ominseo5/robotory_SoftFinger/finger_diff_diameter/DIFF18.png

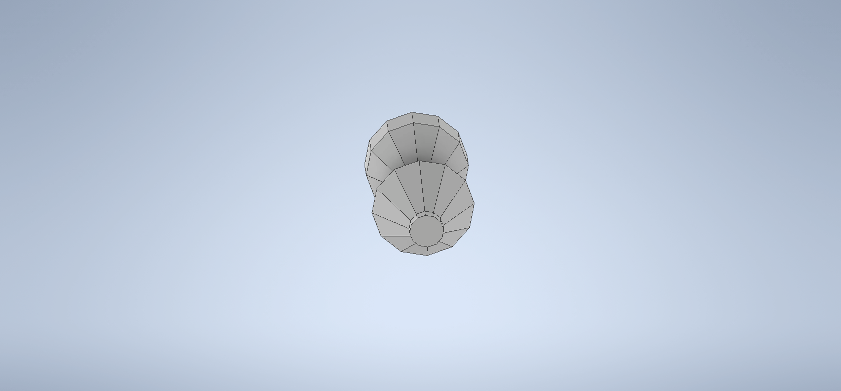
finger_diff_diameter/DIFF18.png
