ominseo5/robotory_SoftFinger/AverageDataSubplot_WithRawData/dn_series.png

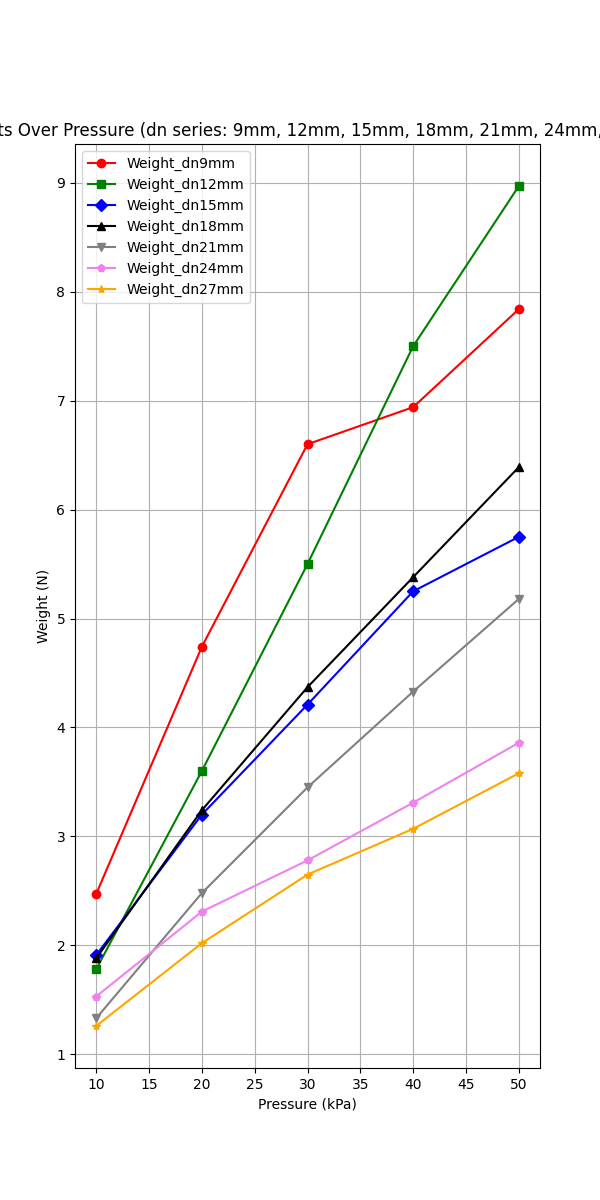
AverageDataSubplot_WithRawData/dn_series.png
