ominseo5/robotory_SoftFinger/AverageDataSubplot_WithRawData/dn_series_indiv.png

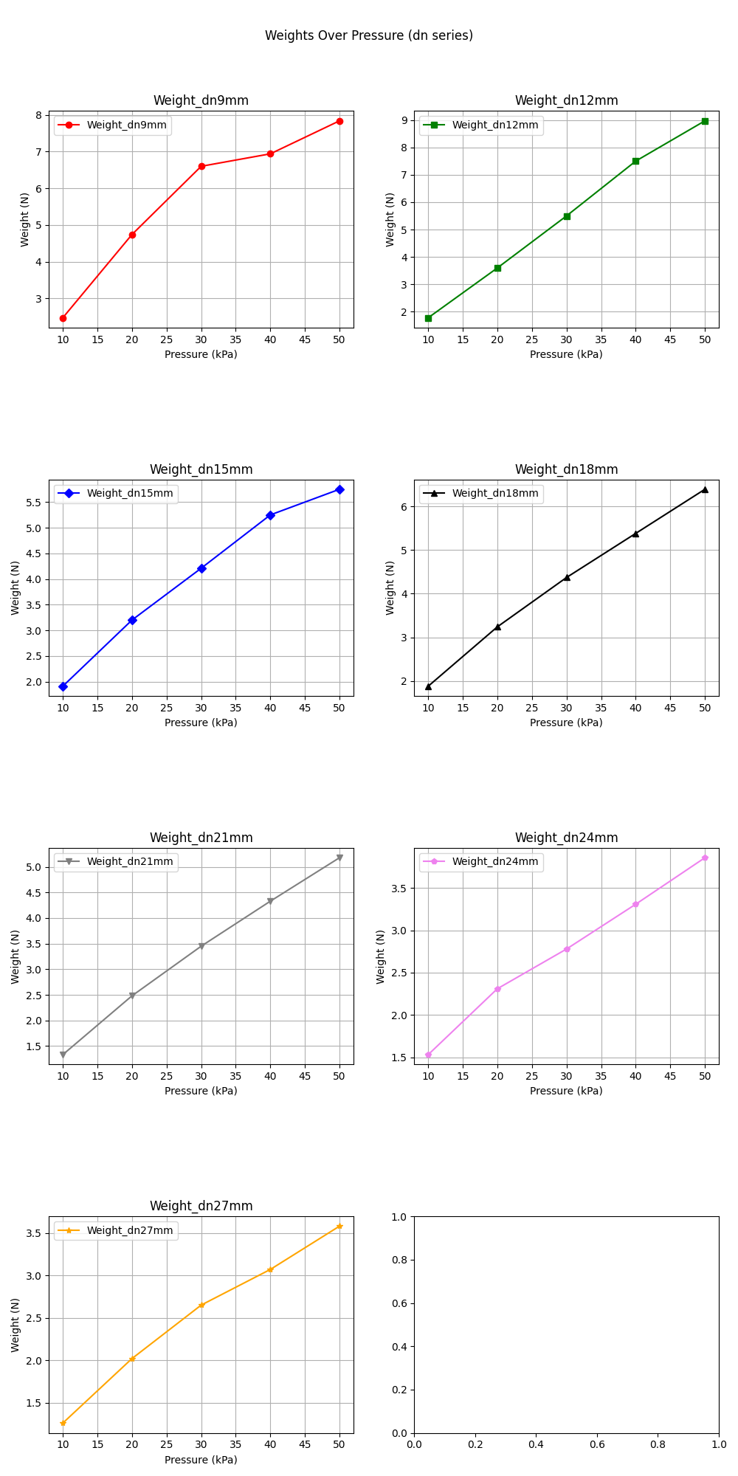
AverageDataSubplot_WithRawData/dn_series_indiv.png
