ominseo5/robotory_SoftFinger/AverageDataSubplot_WithRawData/dp_series.png

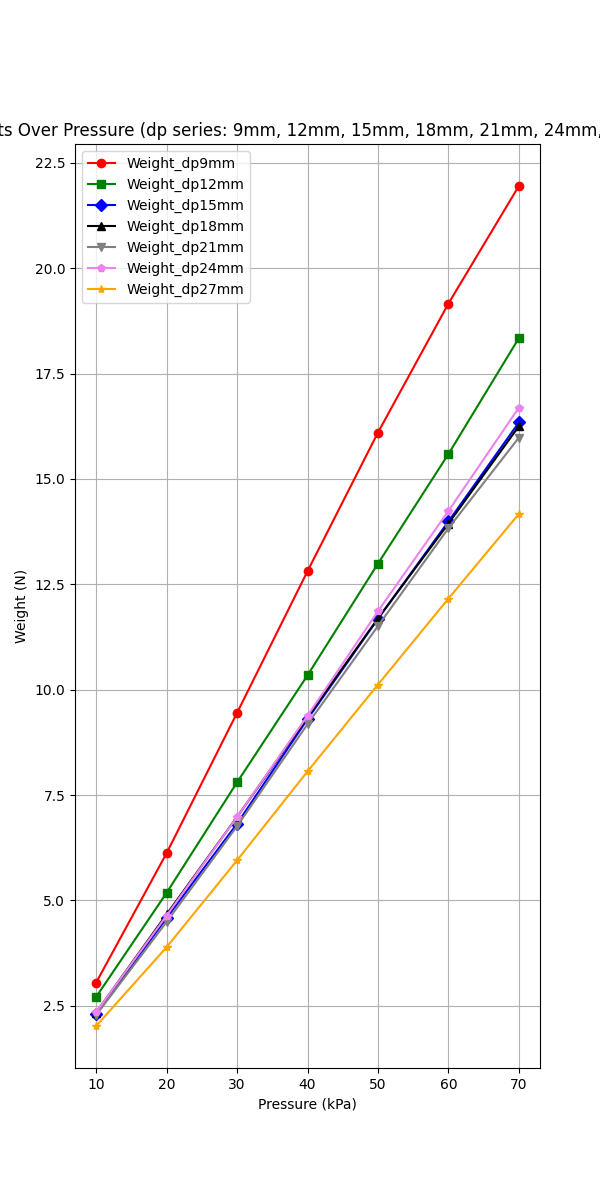
AverageDataSubplot_WithRawData/dp_series.png
