ominseo5/robotory_SoftFinger/AverageDataSubplot_WithRawData/dp_series_indiv.png

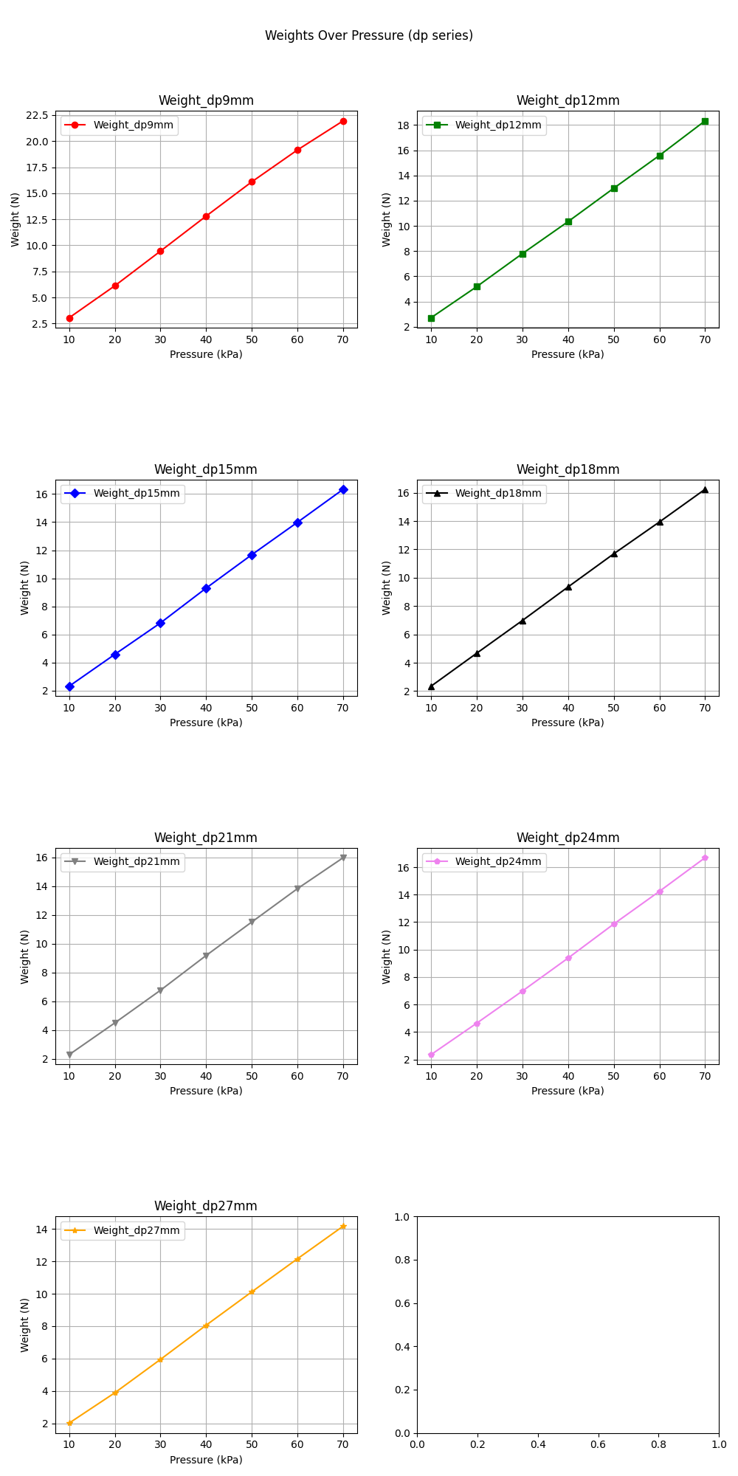
AverageDataSubplot_WithRawData/dp_series_indiv.png
