ominseo5/robotory_SoftFinger/AverageDataSubplot_WithRawData/un_series.png

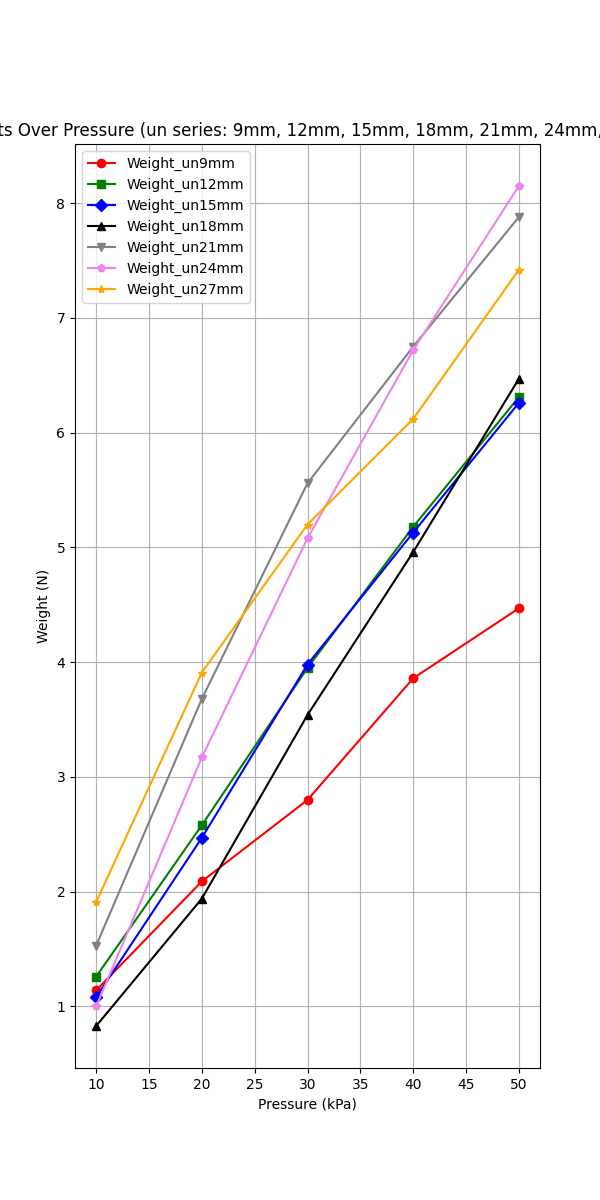
AverageDataSubplot_WithRawData/un_series.png
