ominseo5/robotory_SoftFinger/AverageDataSubplot_WithRawData/un_series_indiv.png

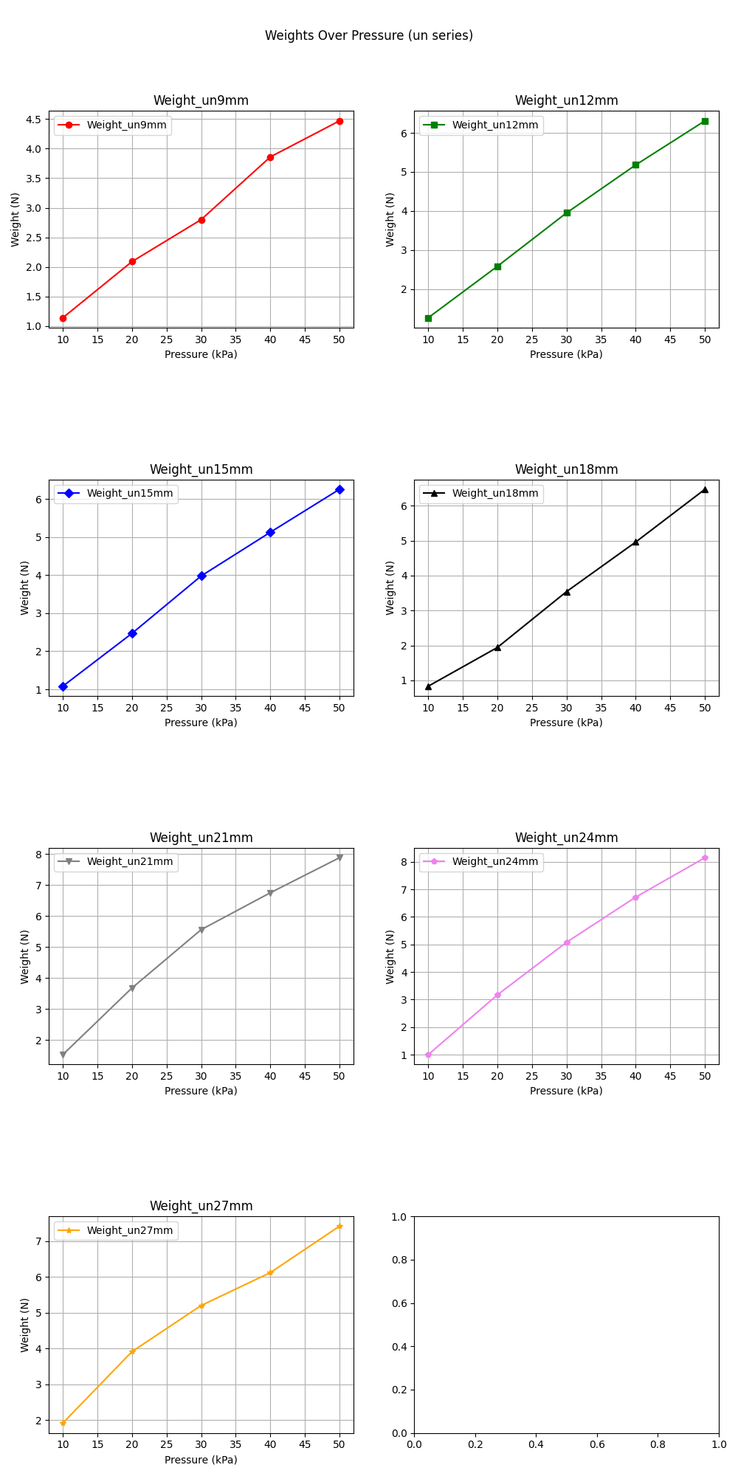
AverageDataSubplot_WithRawData/un_series_indiv.png
