ominseo5/robotory_SoftFinger/AverageDataSubplot_WithRawData/up_series.png

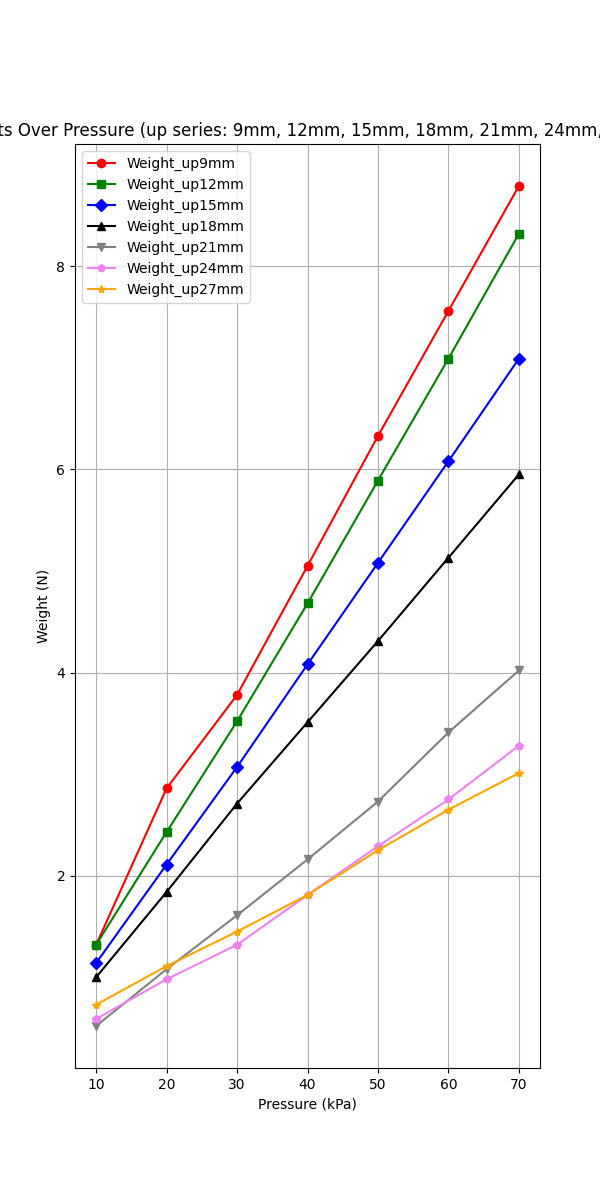
AverageDataSubplot_WithRawData/up_series.png
