ominseo5/robotory_SoftFinger/finger_PNGFiles/d18mm.png

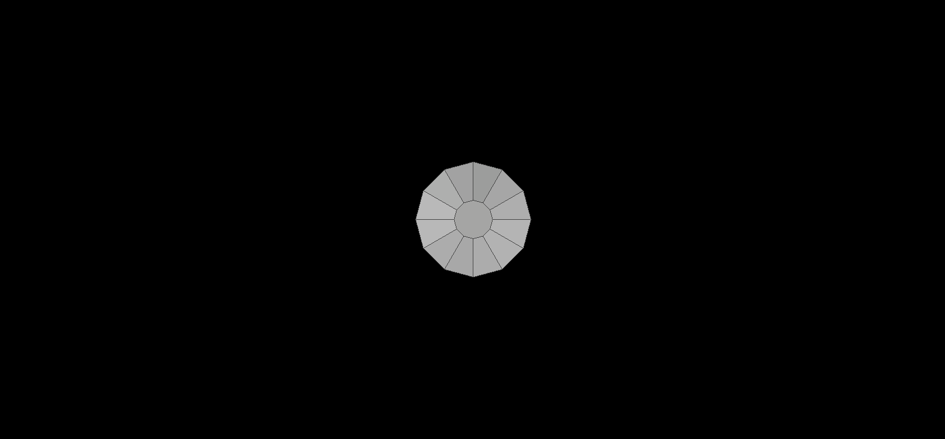
finger_PNGFiles/d18mm.png
