ominseo5/robotory_SoftFinger/finger_PNGFiles/d36mm.png

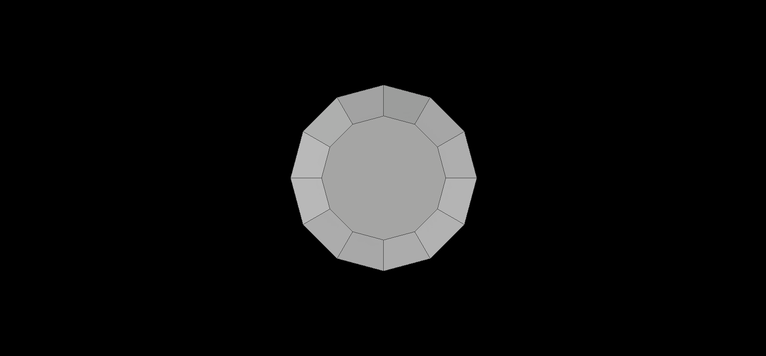
finger_PNGFiles/d36mm.png
