ominseo5/robotory_SoftFinger/finger_PNGFiles/h24mm.png

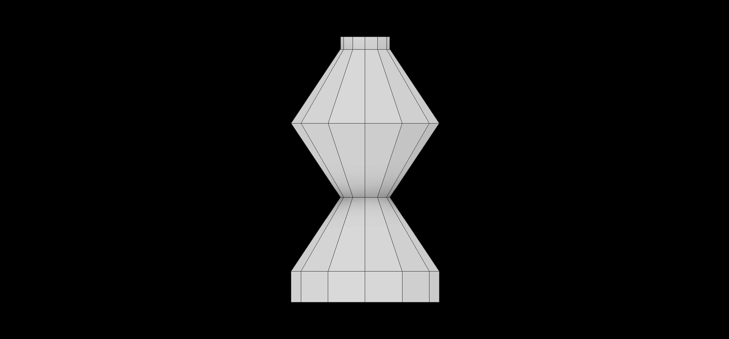
finger_PNGFiles/h24mm.png
