ominseo5/robotory_SoftFinger/PycharmCodes_xlsxFiles/ErrorBars/dn_errorbar_diffn.png

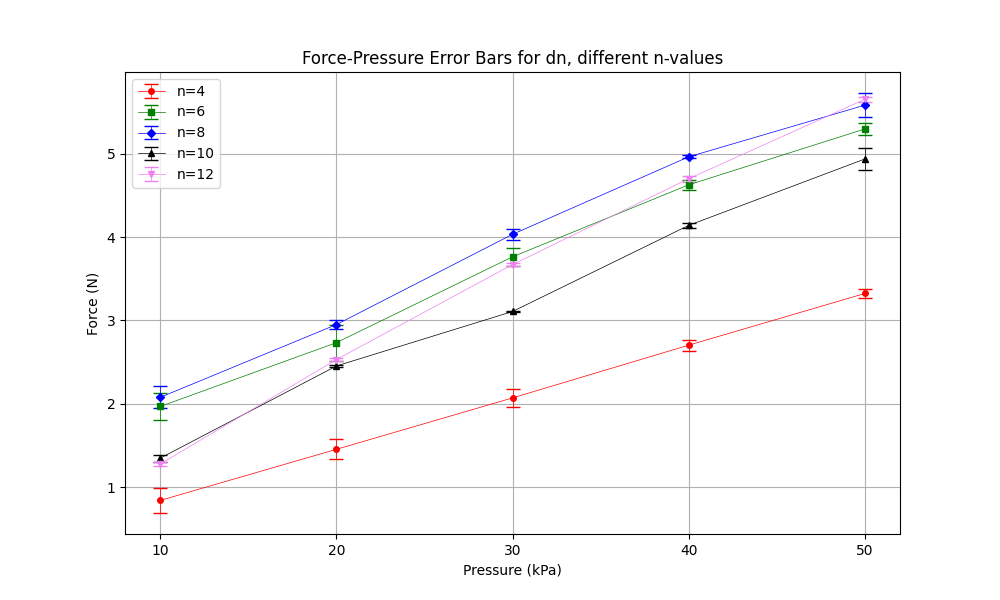
PycharmCodes_xlsxFiles/ErrorBars/dn_errorbar_diffn.png
