ominseo5/robotory_SoftFinger/PycharmCodes_xlsxFiles/ErrorBars/dp_errorbar_diffn.png

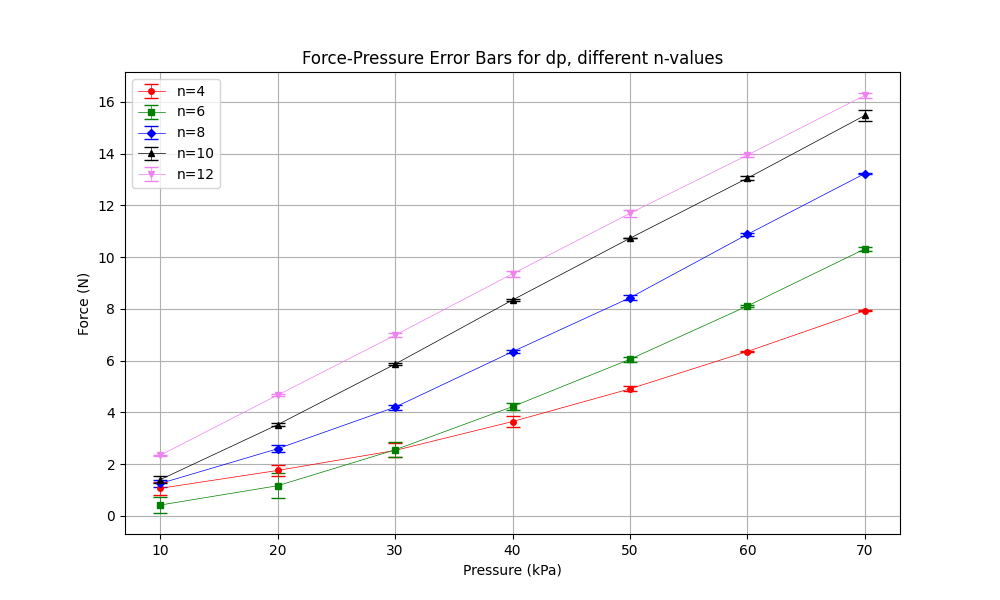
PycharmCodes_xlsxFiles/ErrorBars/dp_errorbar_diffn.png
