ominseo5/robotory_SoftFinger/PycharmCodes_xlsxFiles/ErrorBars/un_errorbar_diffn.png

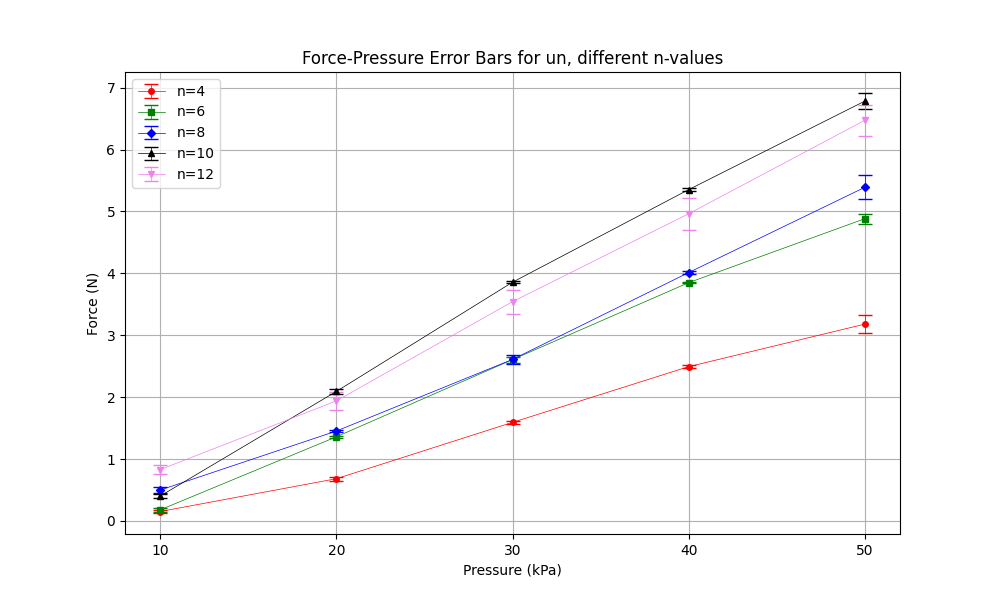
PycharmCodes_xlsxFiles/ErrorBars/un_errorbar_diffn.png
