ominseo5/robotory_SoftFinger/PycharmCodes_xlsxFiles/ErrorBars/up_errorbar_diffn.png

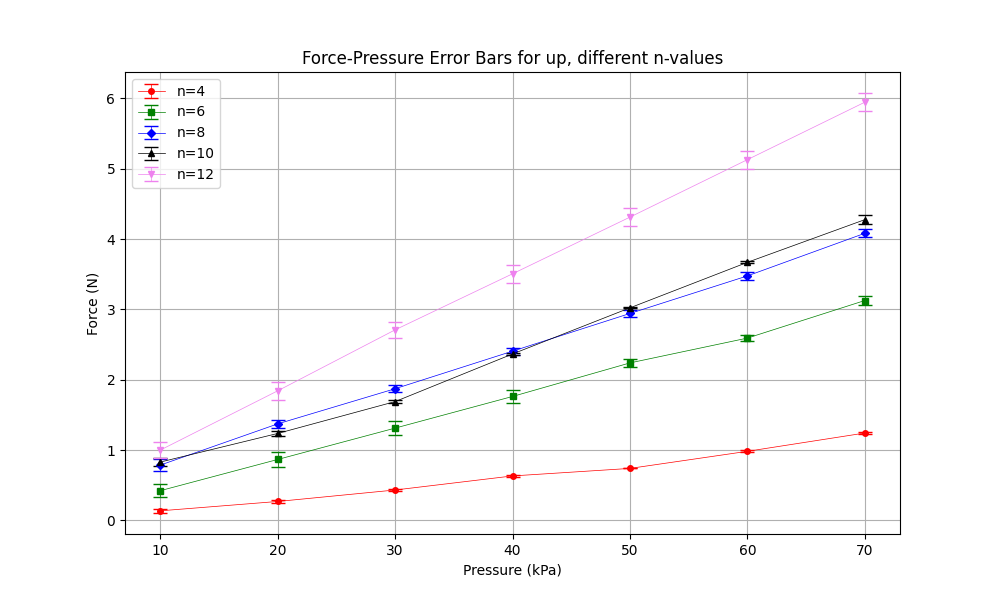
PycharmCodes_xlsxFiles/ErrorBars/up_errorbar_diffn.png
