ominseo5/robotory_SoftFinger/PycharmCodes_xlsxFiles/parameter_to_force/d_dp_paratoF.png

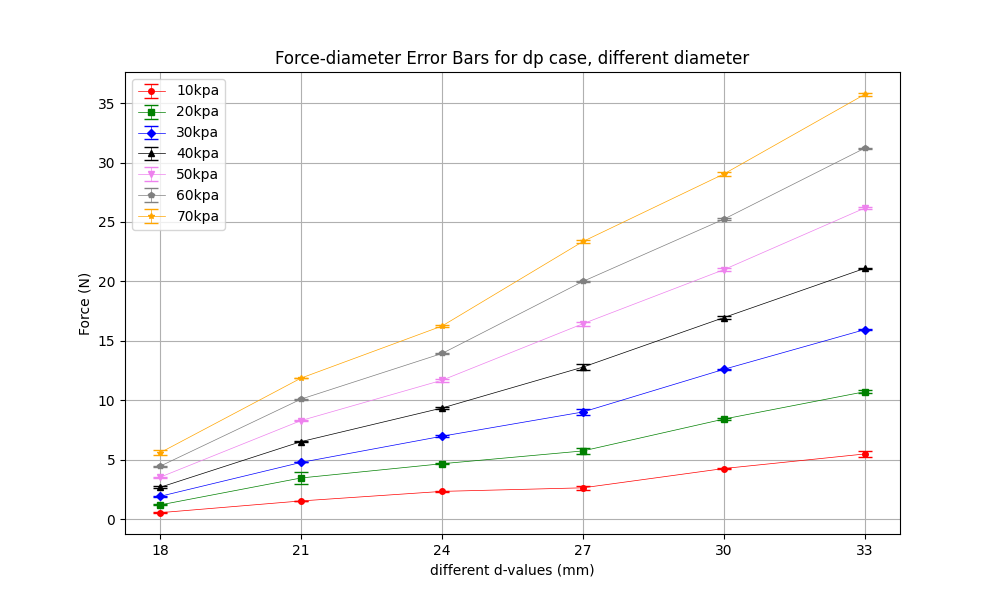
PycharmCodes_xlsxFiles/parameter_to_force/d_dp_paratoF.png
