ominseo5/robotory_SoftFinger/PycharmCodes_xlsxFiles/parameter_to_force/d_up_paratoF.png

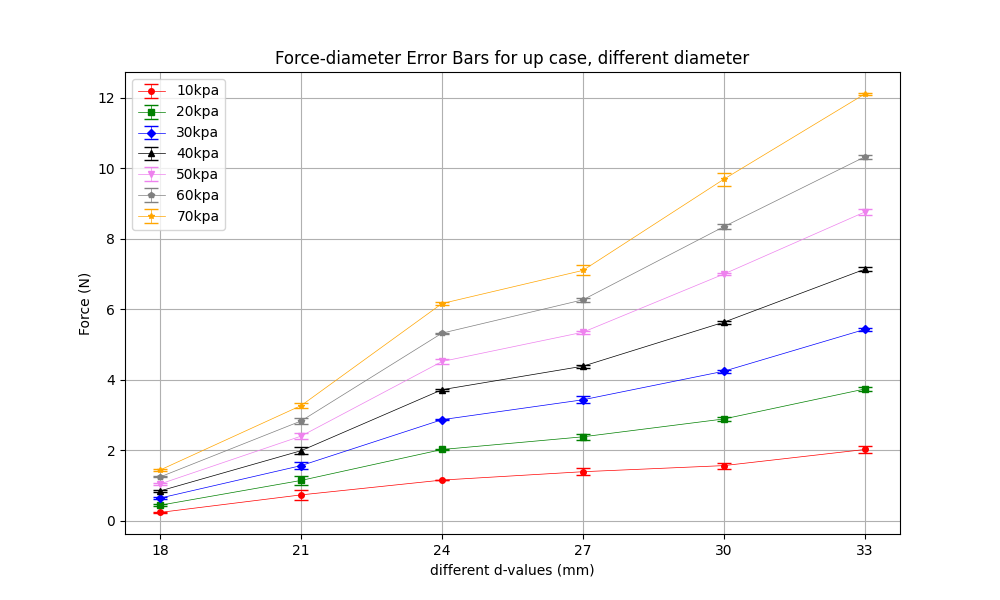
PycharmCodes_xlsxFiles/parameter_to_force/d_up_paratoF.png
