ominseo5/robotory_SoftFinger/PycharmCodes_xlsxFiles/parameter_to_force/h_dn_paratoF.png

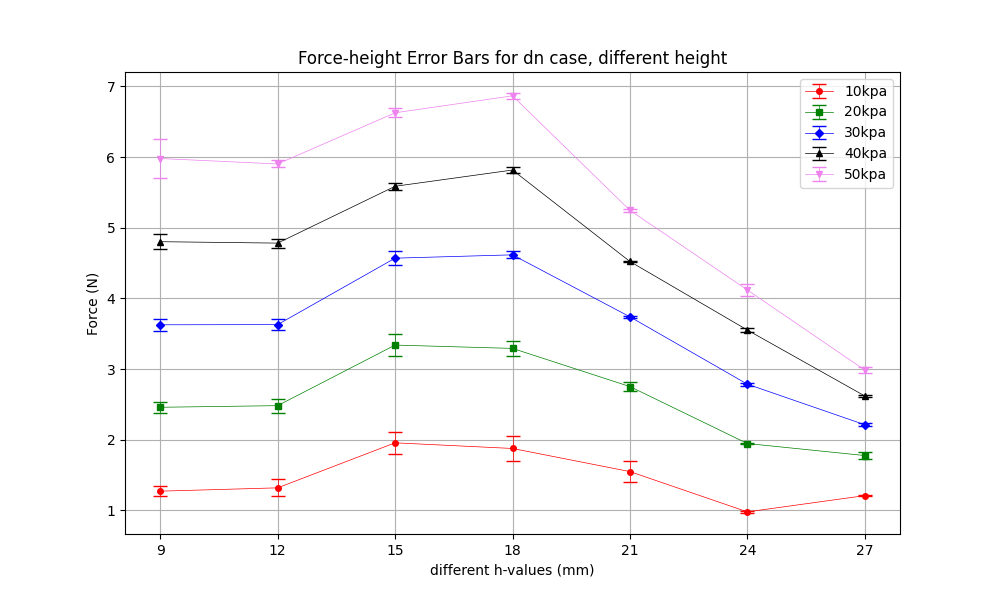
PycharmCodes_xlsxFiles/parameter_to_force/h_dn_paratoF.png
