ominseo5/robotory_SoftFinger/PycharmCodes_xlsxFiles/parameter_to_force/n_un_pararoF.png

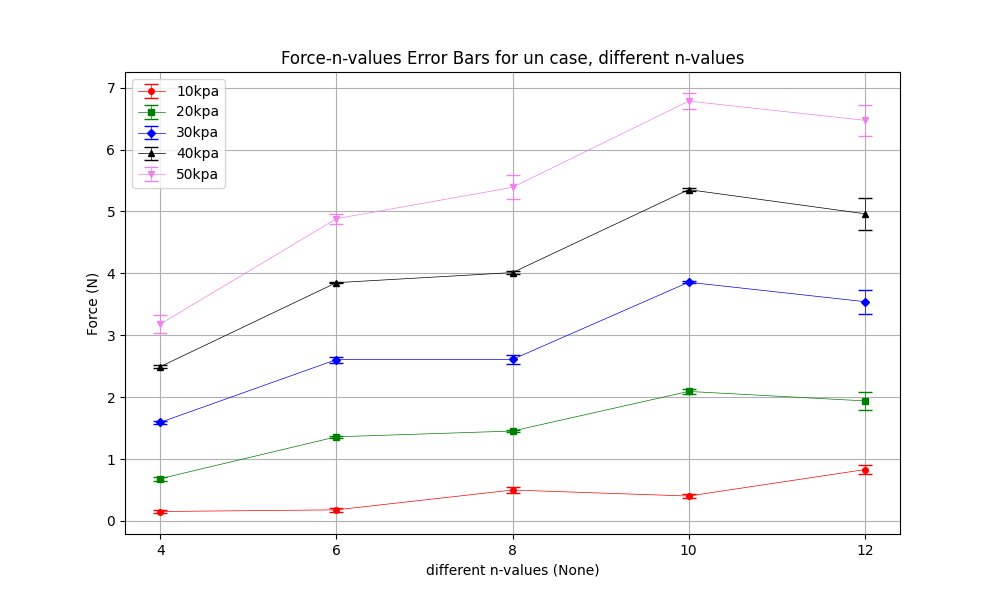
PycharmCodes_xlsxFiles/parameter_to_force/n_un_pararoF.png
