ominseo5/robotory_SoftFinger/PycharmCodes_xlsxFiles/parameter_to_force/n_up_pararoF.png

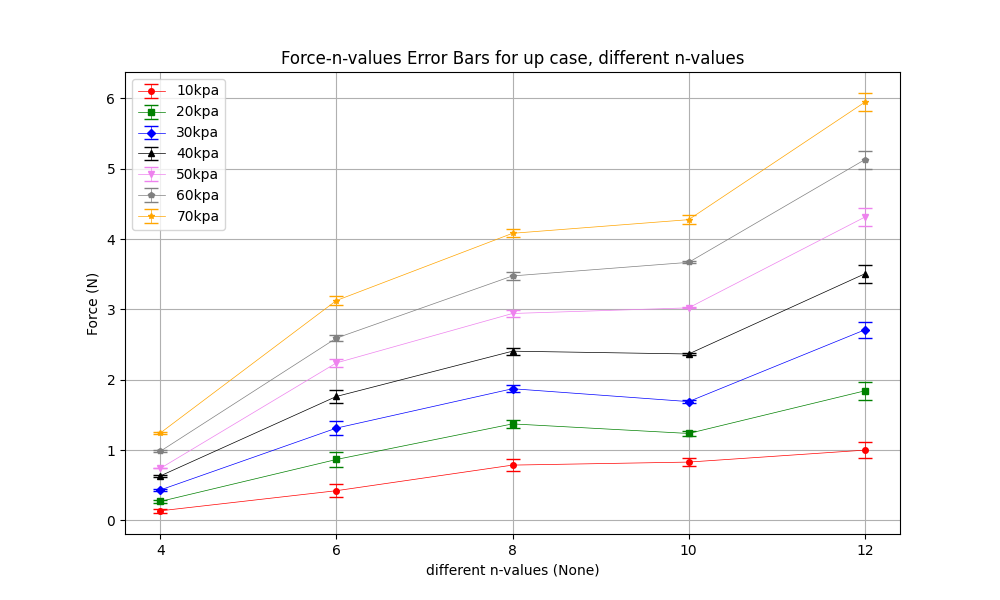
PycharmCodes_xlsxFiles/parameter_to_force/n_up_pararoF.png
