ominseo5/robotory_SoftFinger/finger_diff_diameter/diameter21mm.stp

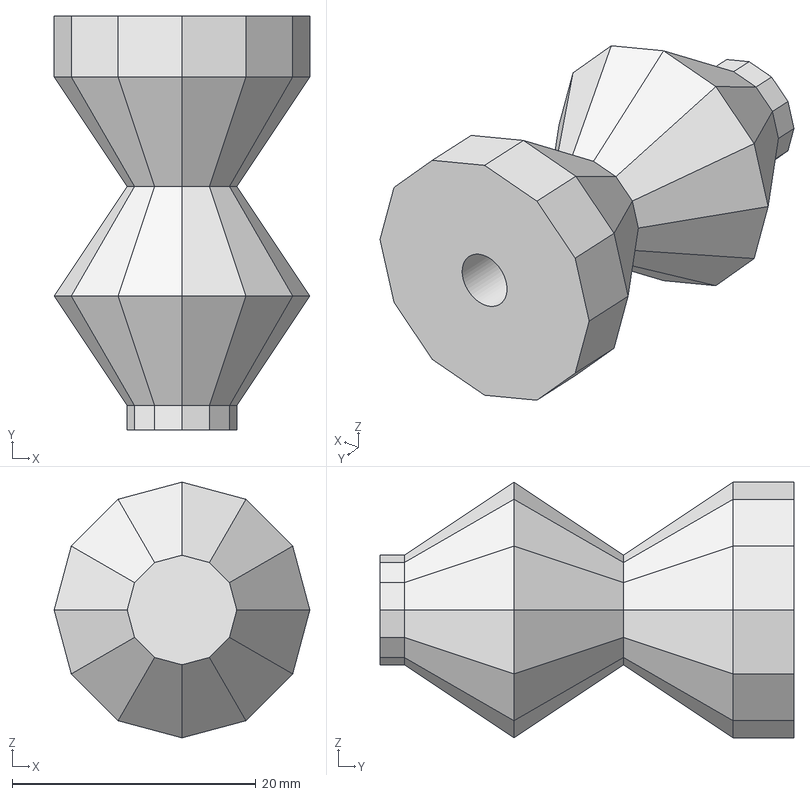
[picture p54: CAD file, 2024-08-09]
finger_diff_diameter/diameter21mm.stp
21.0 x 34.0 x 21.0 mm
