ominseo5/robotory_SoftFinger/finger_diff_n/n_8.stp

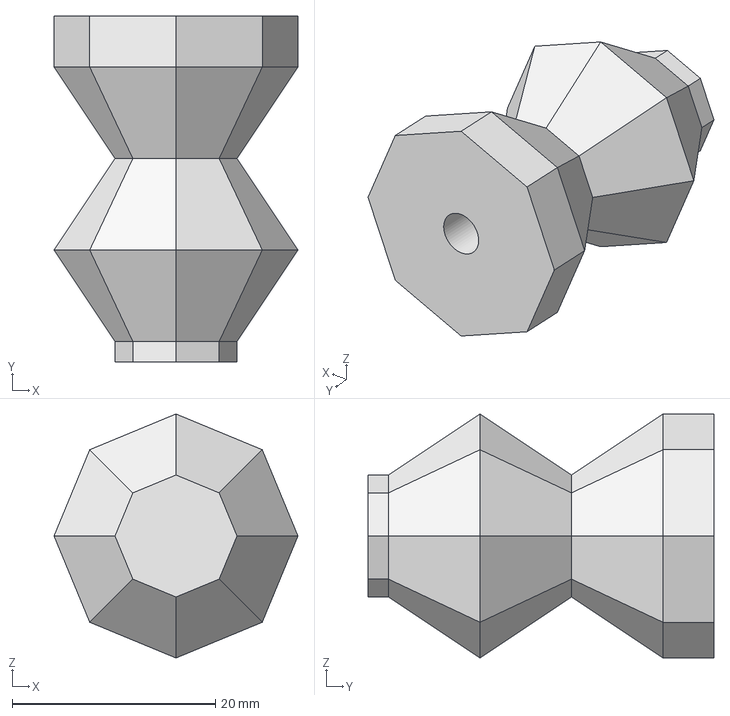
[picture p55: CAD file, 2024-08-14]
finger_diff_n/n_8.stp
24.0 x 34.0 x 24.0 mm
