ominseo5/robotory_SoftFinger/testbed_mount_Inventor/steps_comp/3030_base.STEP

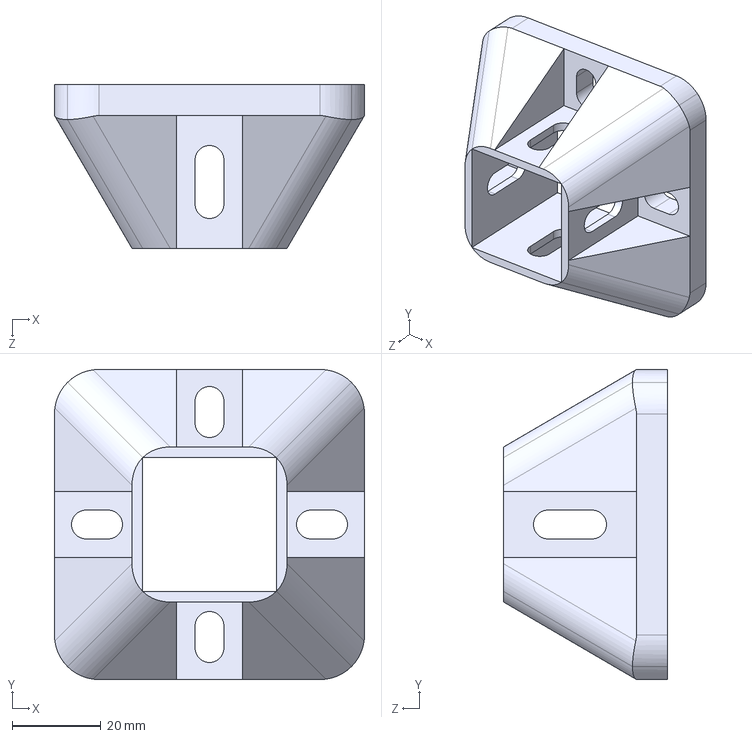
[picture p56: CAD file, 2024-07-30]
testbed_mount_Inventor/steps_comp/3030_base.STEP
70.0 x 70.0 x 37.0 mm
