ominseo5/robotory_SoftFinger/testbed_mount_Inventor/STL_comp/rack_supp.stl

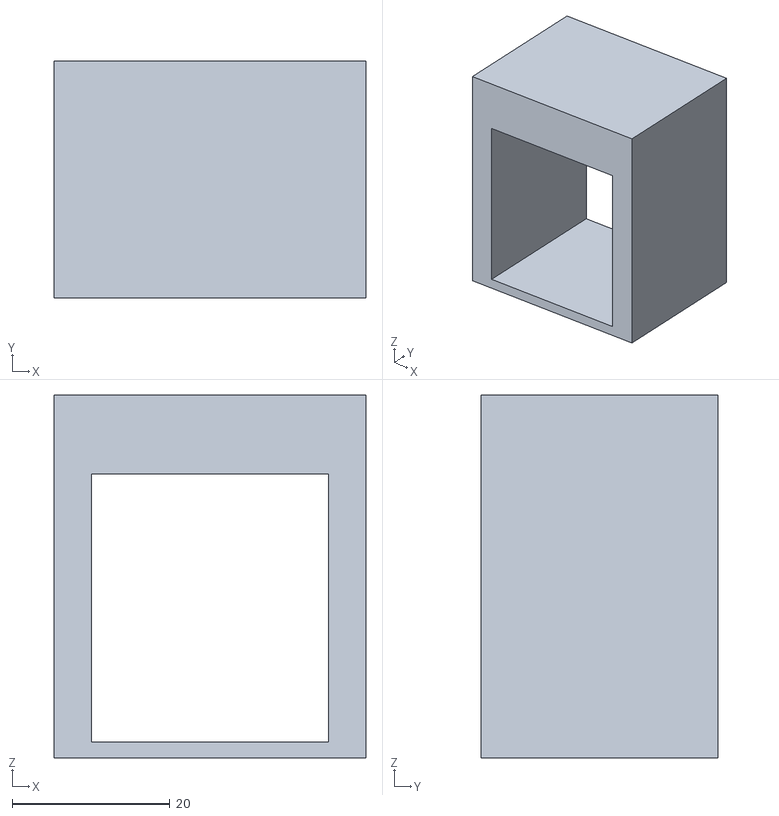
[picture p57: CAD file, 2024-07-30]
testbed_mount_Inventor/STL_comp/rack_supp.stl
39.5 x 30.0 x 46.0
