ominseo5/robotory_SoftFinger/finger_diff_diameter/diameter33mm.stp

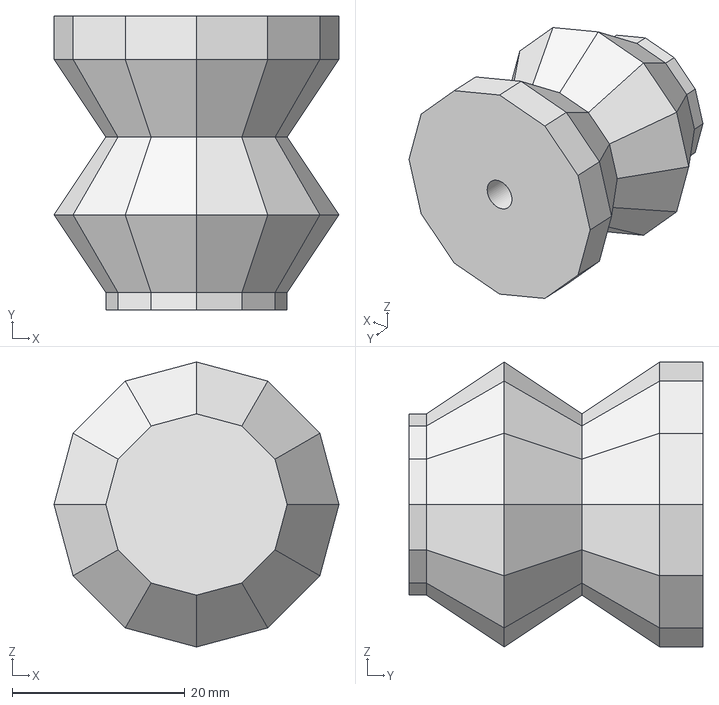
[picture p58: CAD file, 2024-08-09]
finger_diff_diameter/diameter33mm.stp
33.0 x 34.0 x 33.0 mm
