ominseo5/robotory_SoftFinger/finger_diff_n/n_10.stp

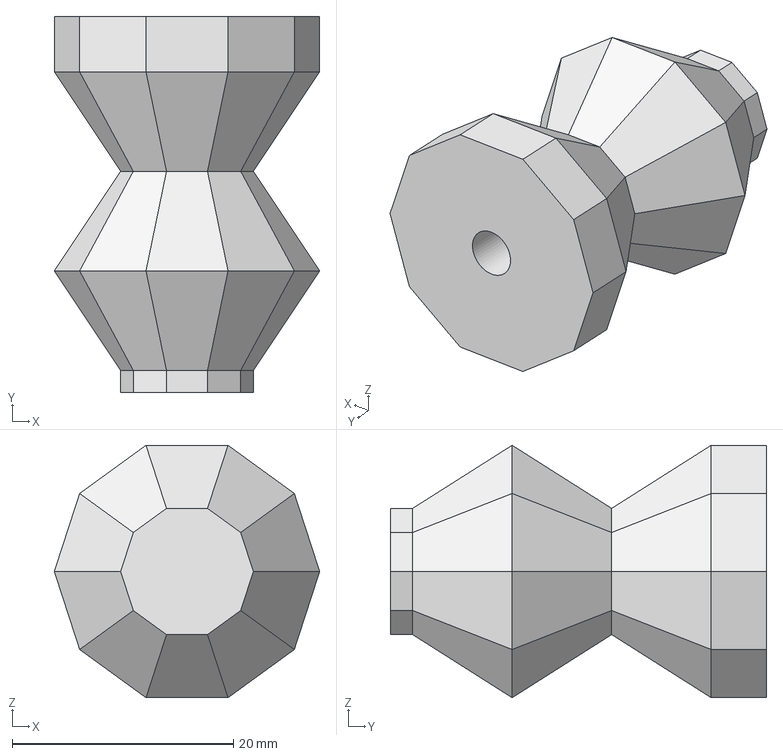
[picture p59: CAD file, 2024-08-14]
finger_diff_n/n_10.stp
24.0 x 34.0 x 22.8 mm
