ominseo5/robotory_SoftFinger/testbed_mount_Inventor/steps_comp/mounting_board_printed.stp

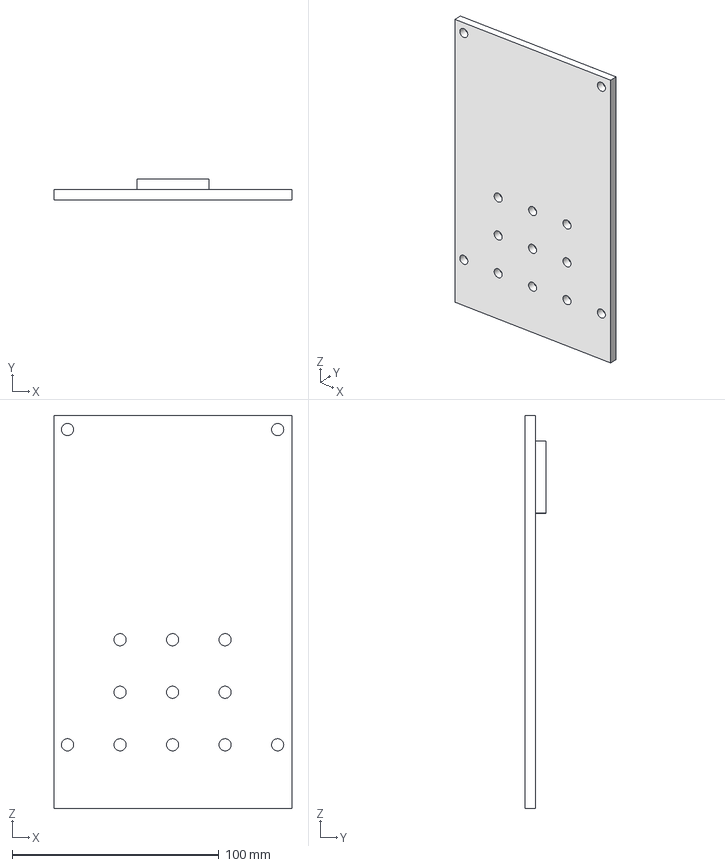
[picture p60: CAD file, 2024-07-30]
testbed_mount_Inventor/steps_comp/mounting_board_printed.stp
115.0 x 10.0 x 190.0 mm
