ominseo5/robotory_SoftFinger/finger_diff_diameter/diameter27mm.stp

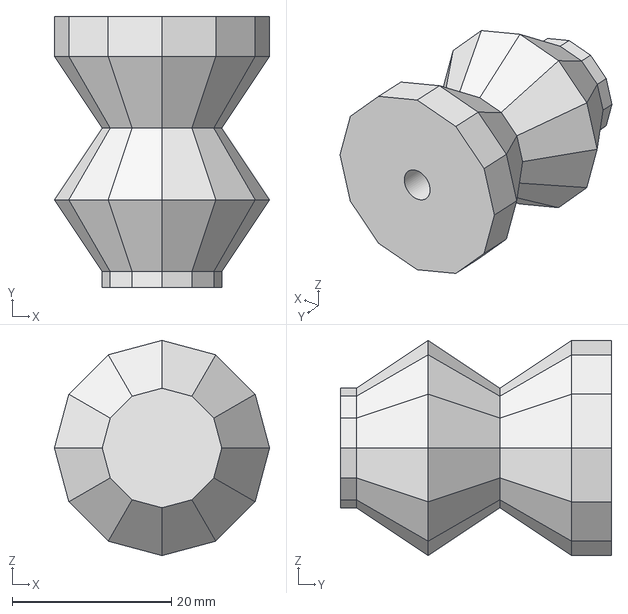
[picture p61: CAD file, 2024-08-09]
finger_diff_diameter/diameter27mm.stp
27.0 x 34.0 x 27.0 mm
