ominseo5/robotory_SoftFinger/finger_diff_n/n_6.stp

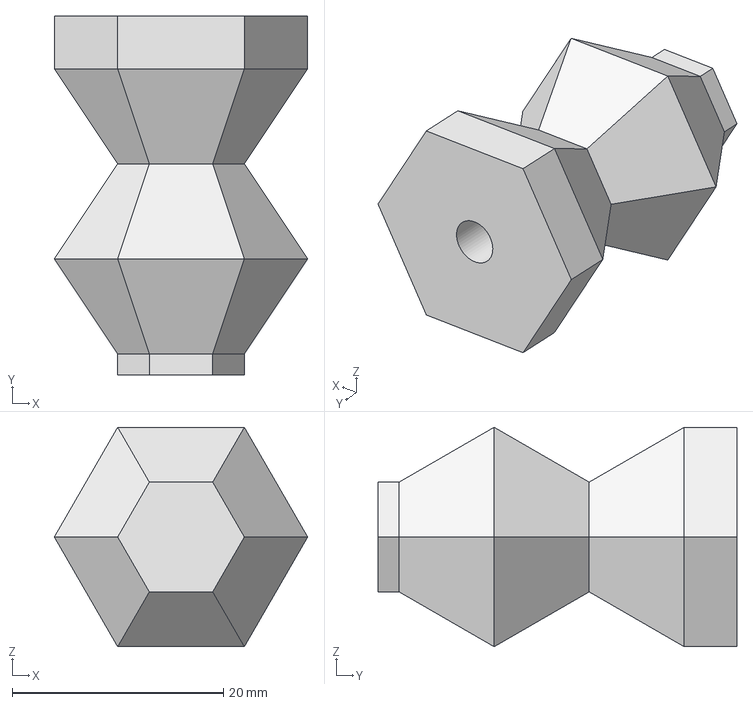
[picture p62: CAD file, 2024-08-14]
finger_diff_n/n_6.stp
24.0 x 34.0 x 20.8 mm
