ominseo5/robotory_SoftFinger/testbed_mount_Inventor/steps_comp/valve_mount_pin.stp

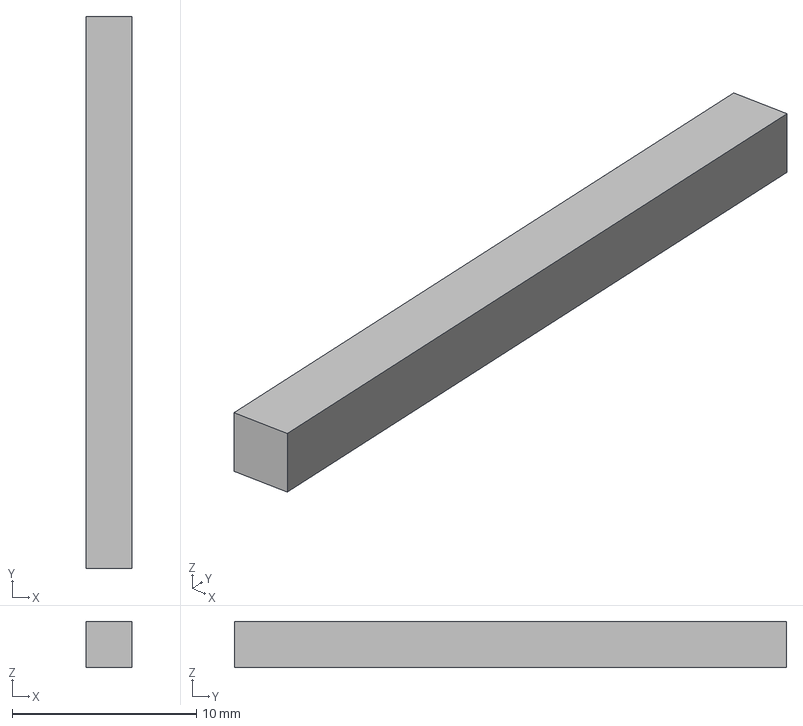
[picture p63: CAD file, 2024-07-30]
testbed_mount_Inventor/steps_comp/valve_mount_pin.stp
2.50 x 30.0 x 2.50 mm
