ominseo5/robotory_SoftFinger/finger_diff_diameter/diameter30mm.stp

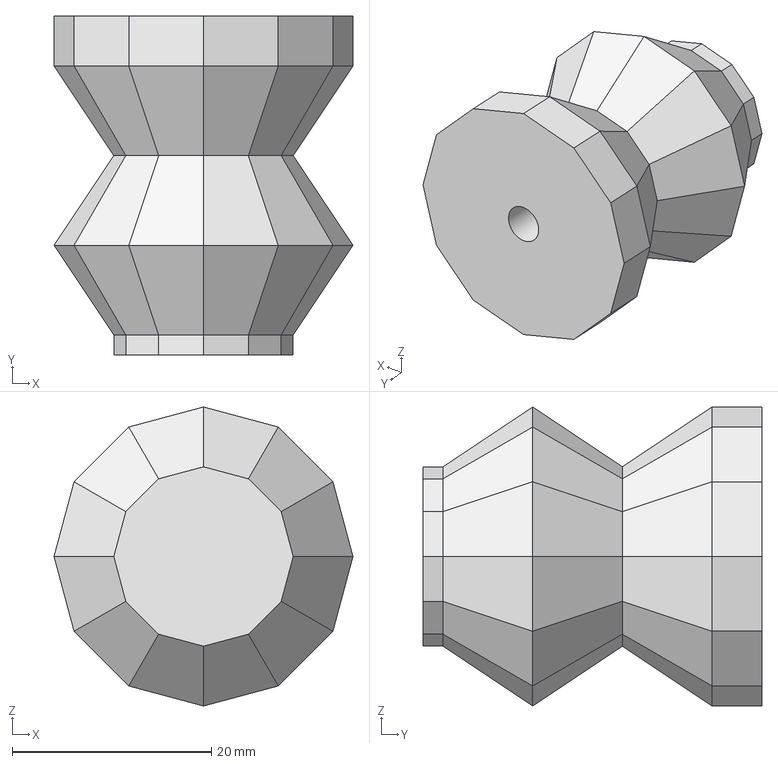
[picture p64: CAD file, 2024-08-09]
finger_diff_diameter/diameter30mm.stp
30.0 x 34.0 x 30.0 mm
