ominseo5/robotory_SoftFinger/finger_diff_n/n_4.stp

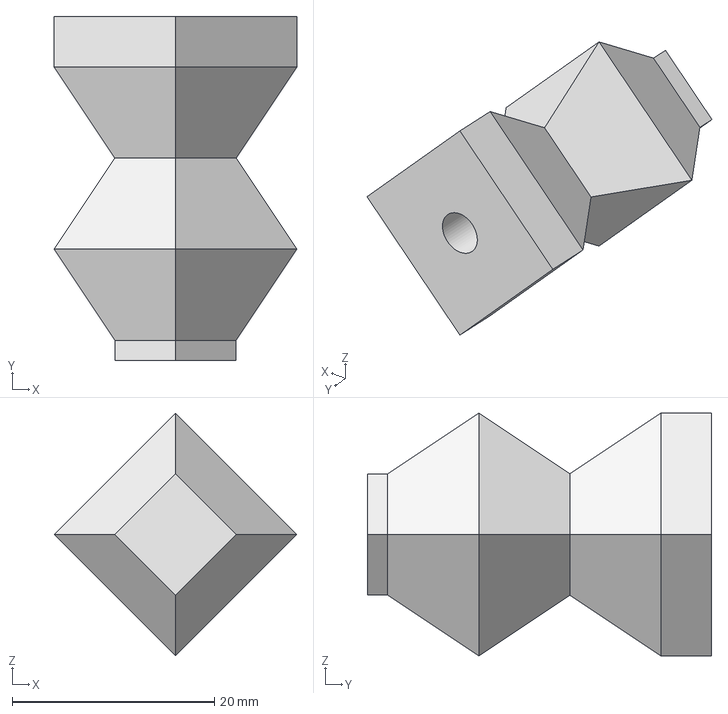
[picture p65: CAD file, 2024-08-14]
finger_diff_n/n_4.stp
24.0 x 34.0 x 24.0 mm
