ominseo5/robotory_SoftFinger/testbed_mount_Inventor/steps_comp/GPL 06M5(L)(3D).STEP

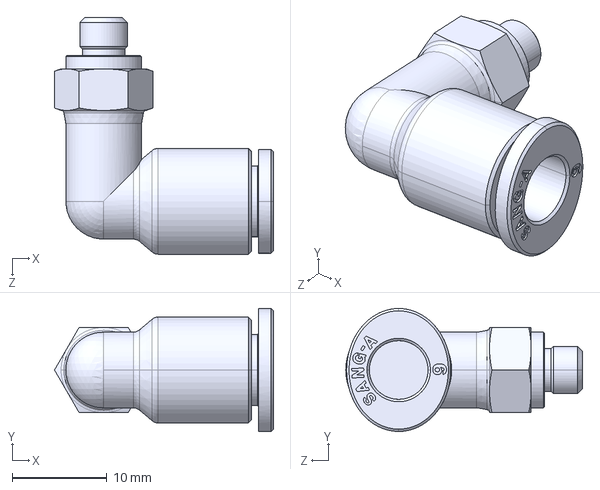
[picture p66: CAD file, 2024-07-30]
testbed_mount_Inventor/steps_comp/GPL 06M5(L)(3D).STEP
23.1 x 13.0 x 25.0 mm
