ominseo5/robotory_SoftFinger/finger_diff_diameter/diameter18mm.stp

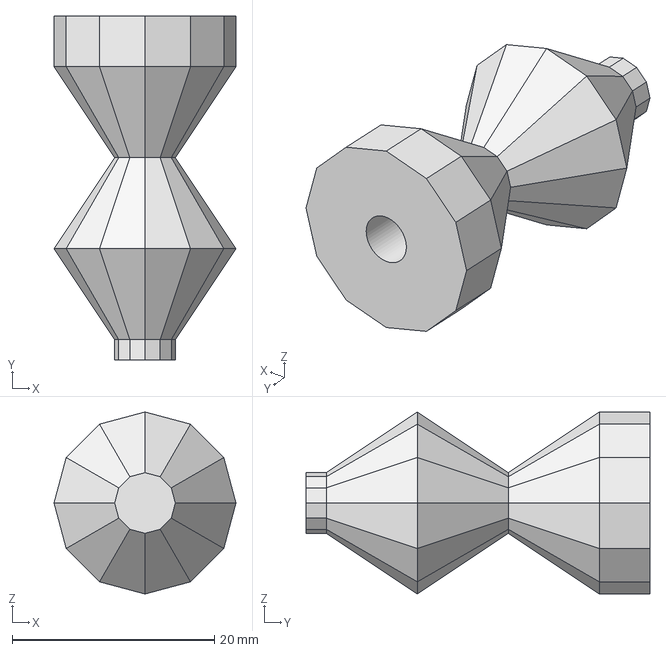
[picture p67: CAD file, 2024-08-08]
finger_diff_diameter/diameter18mm.stp
18.0 x 34.0 x 18.0 mm
