ominseo5/robotory_SoftFinger/testbed_mount_Inventor/steps_comp/lever_handle.stp

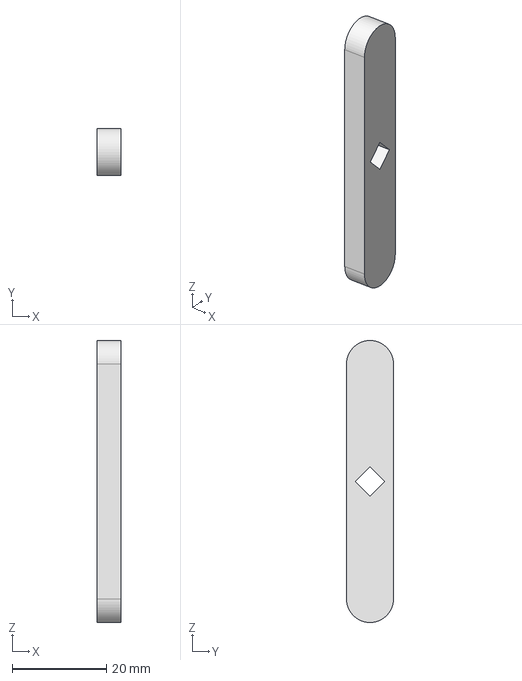
[picture p68: CAD file, 2024-07-30]
testbed_mount_Inventor/steps_comp/lever_handle.stp
5.00 x 10.0 x 60.0 mm
