ominseo5/robotory_SoftFinger/testbed_mount_Inventor/steps_comp/pinion_gear.stp

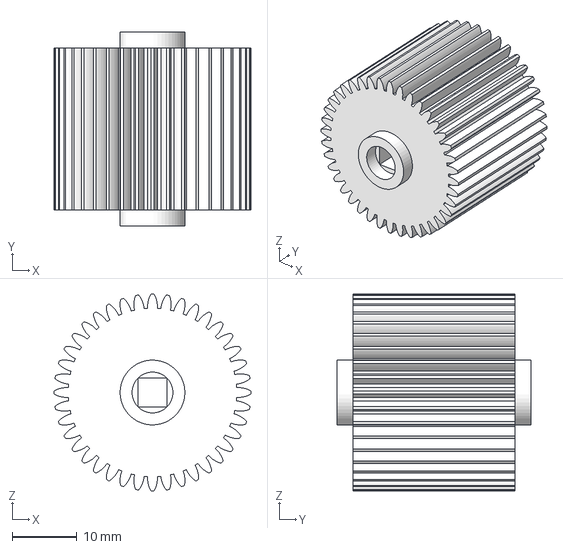
[picture p69: CAD file, 2024-07-30]
testbed_mount_Inventor/steps_comp/pinion_gear.stp
30.4 x 30.0 x 30.4 mm
