ominseo5/robotory_SoftFinger/testbed_mount_Inventor/steps_comp/rack_gear.stp

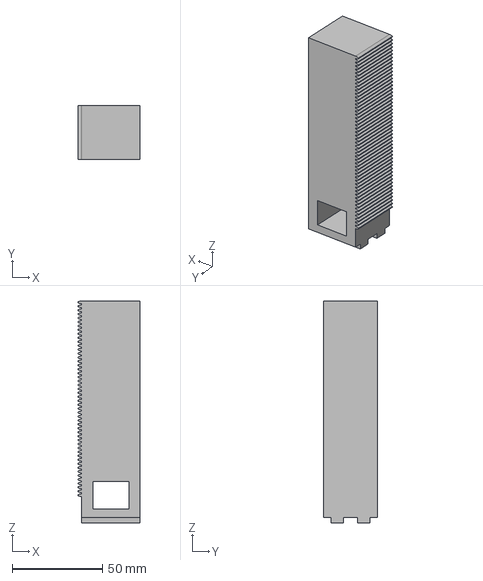
[picture p70: CAD file, 2024-07-30]
testbed_mount_Inventor/steps_comp/rack_gear.stp
34.5 x 30.0 x 123.0 mm
