ominseo5/robotory_SoftFinger/testbed_mount_Inventor/steps_comp/stopper.stp

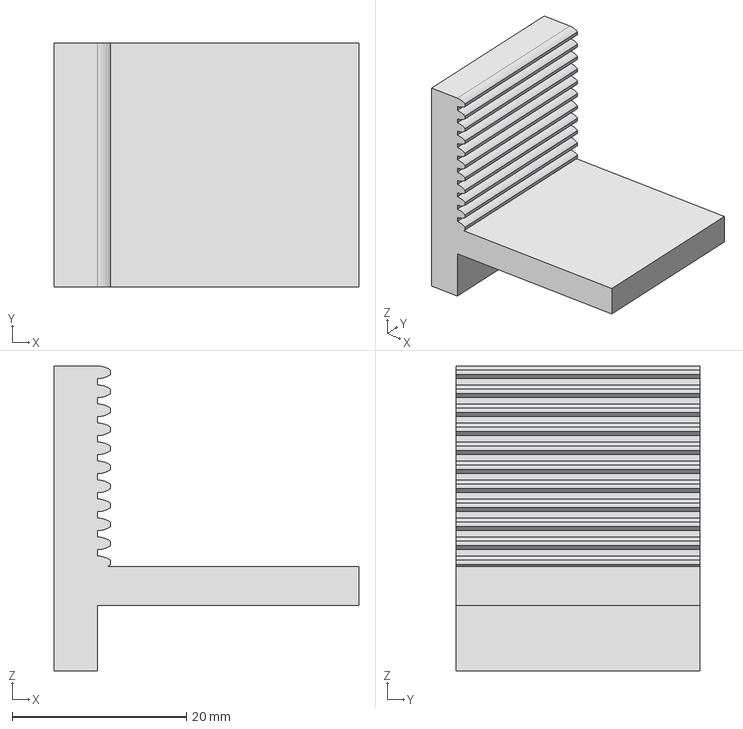
[picture p71: CAD file, 2024-07-30]
testbed_mount_Inventor/steps_comp/stopper.stp
35.0 x 28.0 x 35.0 mm
