ominseo5/robotory_SoftFinger/testbed_mount_Inventor/steps_comp/lever_support.stp

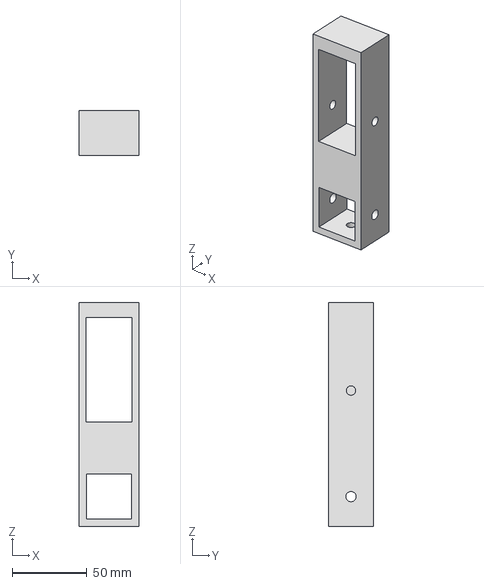
[picture p72: CAD file, 2024-07-30]
testbed_mount_Inventor/steps_comp/lever_support.stp
40.1 x 30.0 x 150.0 mm
