ominseo5/robotory_SoftFinger/testbed_mount_Inventor/steps_comp/valve_mount.stp

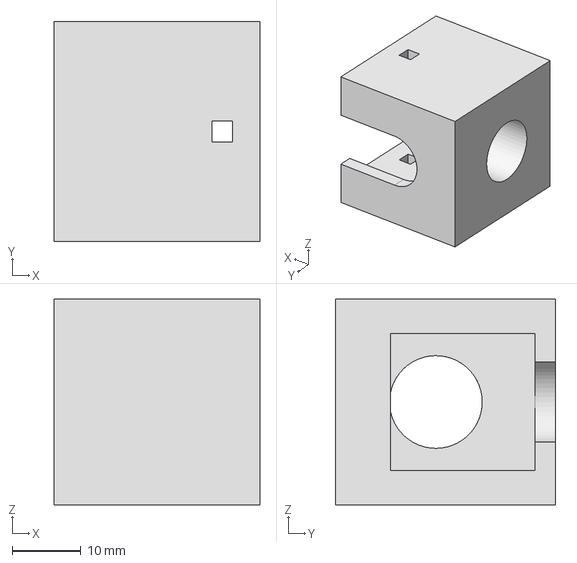
[picture p73: CAD file, 2024-07-30]
testbed_mount_Inventor/steps_comp/valve_mount.stp
30.0 x 32.0 x 30.0 mm
