ominseo5/robotory_SoftFinger/(list of files, cad)

Other CAD files:
finger_diff_diameter/OldVersions/diameter36mm.0001.ipt
finger_diff_diameter/diameter18mm.ipt
finger_diff_diameter/diameter21mm.ipt
finger_diff_diameter/diameter27mm.ipt
finger_diff_diameter/diameter30mm.ipt
finger_diff_diameter/diameter33mm.ipt
finger_diff_diameter/diameter36mm.ipt
finger_diff_n/OldVersions/n_4.0001.ipt
finger_diff_n/n_10.ipt
finger_diff_n/n_4.ipt
finger_diff_n/n_6.ipt
finger_diff_n/n_8.ipt
testbed_mount_Inventor/3030_base.ipt
testbed_mount_Inventor/3030column.ipt
testbed_mount_Inventor/GPL 06M5(L)(3D).iam
testbed_mount_Inventor/GPL 06M5(L)(3D).stp.iam
testbed_mount_Inventor/OldVersions/3030column.0007.ipt
testbed_mount_Inventor/OldVersions/lever_support.0014.ipt
testbed_mount_Inventor/OldVersions/mount_assembly.0035.iam
testbed_mount_Inventor/OldVersions/mounting_board.0001.ipt
testbed_mount_Inventor/OldVersions/mounting_board_printed.0017.ipt
testbed_mount_Inventor/OldVersions/pinion_gear.0016.ipt
testbed_mount_Inventor/OldVersions/rack_gear.0015.ipt
testbed_mount_Inventor/OldVersions/rack_supp.0002.ipt
testbed_mount_Inventor/OldVersions/rp_lever.0012.ipt
testbed_mount_Inventor/OldVersions/stopper.0001.ipt
testbed_mount_Inventor/OldVersions/valve_mount.0010.ipt
testbed_mount_Inventor/OldVersions/valve_mount_pin.0003.ipt
testbed_mount_Inventor/OldVersions/렉기어.0014.ipt
testbed_mount_Inventor/OldVersions/피니언기어.0013.ipt
testbed_mount_Inventor/STL_comp/lever_support.stl
testbed_mount_Inventor/STL_comp/mounting_board_printed.stl
testbed_mount_Inventor/STL_comp/pinion_gear.stl
testbed_mount_Inventor/STL_comp/valvemount.stl
testbed_mount_Inventor/STL_comp/valvemountpin.stl
testbed_mount_Inventor/____1.stp.ipt
testbed_mount_Inventor/cell_pin.ipt
testbed_mount_Inventor/finger.ipt
testbed_mount_Inventor/lever_handle.ipt
testbed_mount_Inventor/lever_support.ipt
testbed_mount_Inventor/loadcell.ipt
testbed_mount_Inventor/mount_assembly.iam
testbed_mount_Inventor/mounting_board.ipt
testbed_mount_Inventor/mounting_board_printed.ipt
testbed_mount_Inventor/pinion_gear.ipt
testbed_mount_Inventor/rack_gear.ipt
testbed_mount_Inventor/rack_supp.ipt
testbed_mount_Inventor/rp_lever.ipt
testbed_mount_Inventor/spring_mount.ipt
testbed_mount_Inventor/steps_comp/3030_base.stp
testbed_mount_Inventor/stopper.ipt
testbed_mount_Inventor/valve_mount.ipt
testbed_mount_Inventor/valve_mount_pin.ipt
