ominseo5/robotory_SoftFinger/(commit log)

2024-07-30 개인정보 삭제
2024-07-31 PycharmCodes_xlsxFiles error correction
    [FingerForce_data.csv, FingerForce_data_combine12.csv, FingerForce_data_combine15.csv, FingerForce_data_combine18.csv, FingerForce_data_combine21.csv, FingerForce_data_combine24.csv, FingerForce_data_combine27.csv, FingerForce_data_combine9.csv]
2024-07-31 주석 추가연습
2024-07-31 lablog 수정 at 0731
2024-07-31 renewed exp 0731
    [data_return_0726.xlsx, zNex~$haredata_return_0726.xlsx]
2024-08-06 0806update with new notebook version
    [data_return_0726.xlsx, zNex~$haredata_return_0726.xlsx]
2024-08-06 with diff_thickness_p-pressure data
    [18mm_ThickVar.xlsx, var_thick_data18mm.xlsx]
2024-08-08 0807update - exp about var thickness and data/errorbar
    [18mm_ThickVar.xlsx, 18mm_ThickVar_negative.xlsx, FingerForce_data_combine18.csv, diameter18mm.ipt, diameter18mm.stp, var_thick_data18mm.xlsx]
2024-08-09 0808update - exp diff diameter, 18, 30 / 0809 continuing 21,27,33
    [18mm_ThickVar.xlsx, 18mm_ThickVar_negative.xlsx, 18mm_diff_diameter.csv, FingerForce_data.csv, FingerForce_data_combine12.csv, FingerForce_data_combine15.csv, FingerForce_data_combine18.csv, FingerForce_data_combine21.csv]
2024-08-09 lablog update 0809
    [var_diam_data18mm.xlsx]
2024-08-09 0809 var-diameter exp completed
    [18mm_diff_diameter.csv, var_diam_data18mm.xlsx]
2024-08-14 diff n-models and raw data organized
    [18mm_ThickVar.xlsx, 18mm_ThickVar_negative.xlsx, n_10.ipt, n_10.stp, n_4.0001.ipt, n_4.ipt, n_4.stp, n_6.ipt]
2024-08-14 0814 updata-including parameter-to-force plots, models for different n values
    [parameter_to_force_d.xlsx, parameter_to_force_h.xlsx, parameter_to_force_n.xlsx, parameter_to_force_t.xlsx, var_diam_data18mm.xlsx]
2024-08-20 ~0819 update without different n
    [FingerForce_data_combine12_new_neg.csv, FingerForce_data_combine12_new_neg2.csv, FingerForce_data_table.csv]
2024-08-22 update with final parameter-change-experiment
    [data_return_0726.xlsx, parameter_to_force_n.xlsx, raw_data_diff_n.csv, var_diam_data18mm.xlsx, var_diam_data_h18mm.xlsx, var_height_data_d24mm.xlsx, var_n_data_h18mm.xlsx, var_thick_data18mm.xlsx]
2024-09-04 update with yield_n and yield_d
    [raw_data_yield_d.csv, raw_data_yield_n.csv, raw_data_yield_n.xlsx, spring_mount.ipt]
