ominseo5/robotory_SoftFinger/(notices)

Notices in the files:
testbed_mount_Inventor/steps_comp/GPL 06M5(L)(3D).STEP:
FILE_NAME ('GPL 06M5(L)(3D).STEP',
